GadgetReboot/PT2399_Breakout/README.md

# PT2399_Breakout
PT2399 Echo IC Breakout Board 
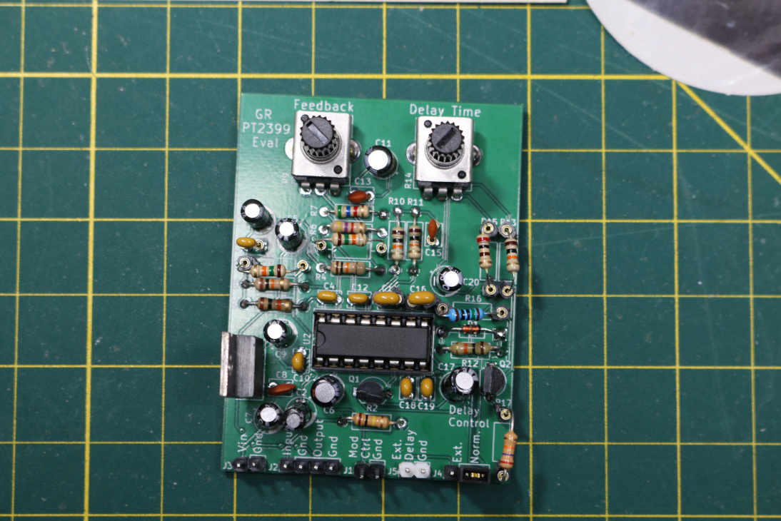
[picture p1: Assembled_PCB.JPG]
PCB
<br><br><BR><BR>
