GadgetReboot/PT2399_Breakout/GR_PT2399_Breakout_Sch.pdf

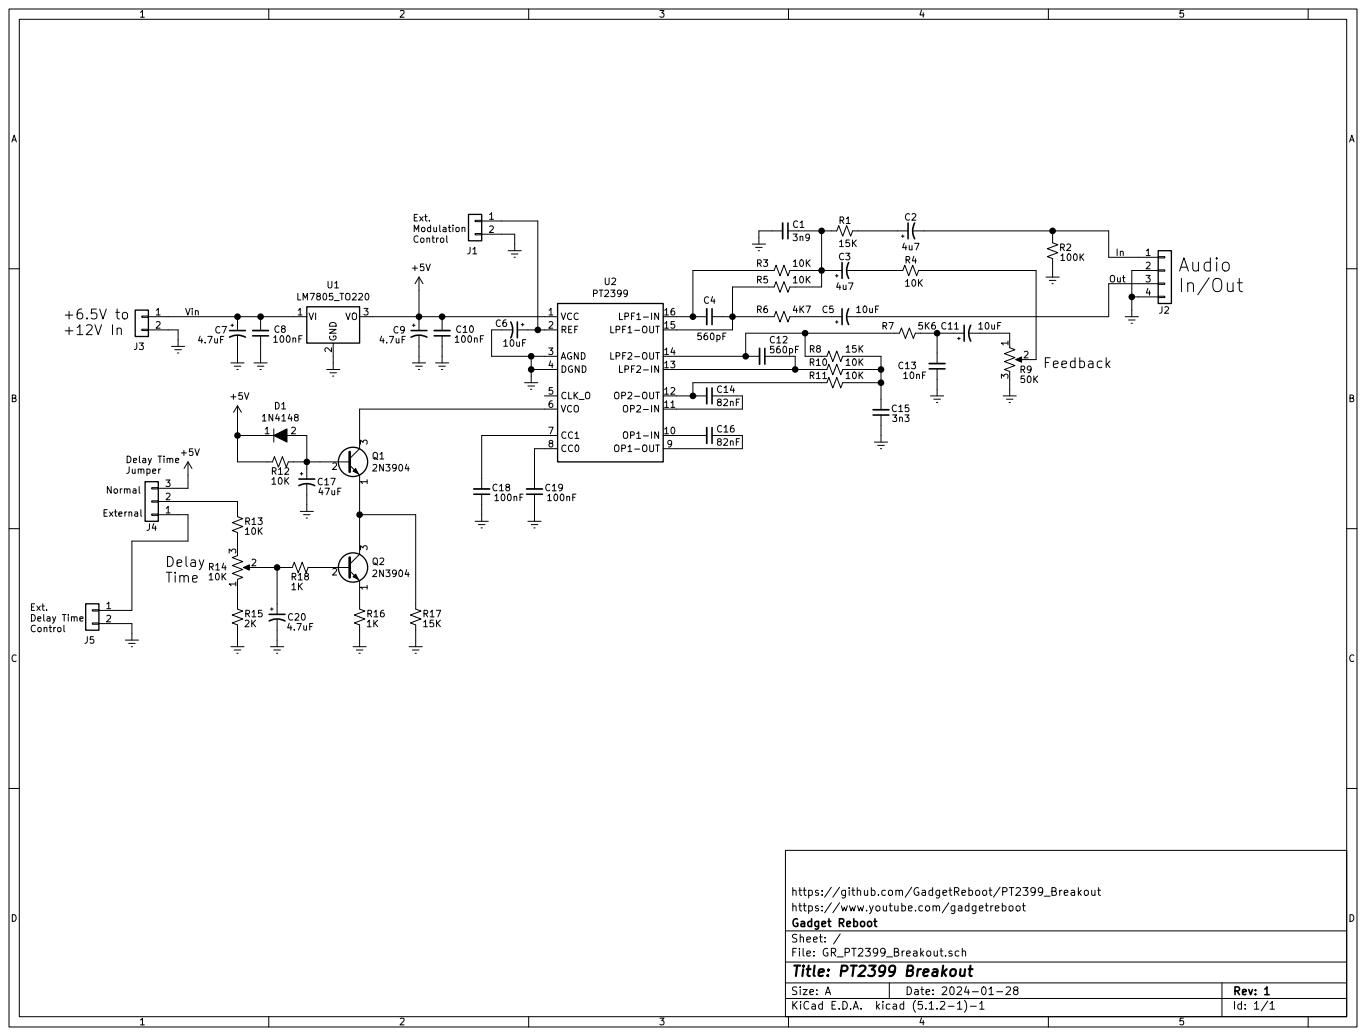
[picture p2: page 1]

Vin Ext. Delay Time Control

https://github.com/GadgetReboot/PT2399_Breakout
https://www.youtube.com/gadgetreboot
File: GR_PT2399_Breakout.sch Sheet: / Gadget Reboot
