GadgetReboot/PT2399_Breakout/KiCad/GR_PT2399_Breakout.kicad_pcb

## KiCad design KiCad/GR_PT2399_Breakout.kicad_pcb (2024-02-20)

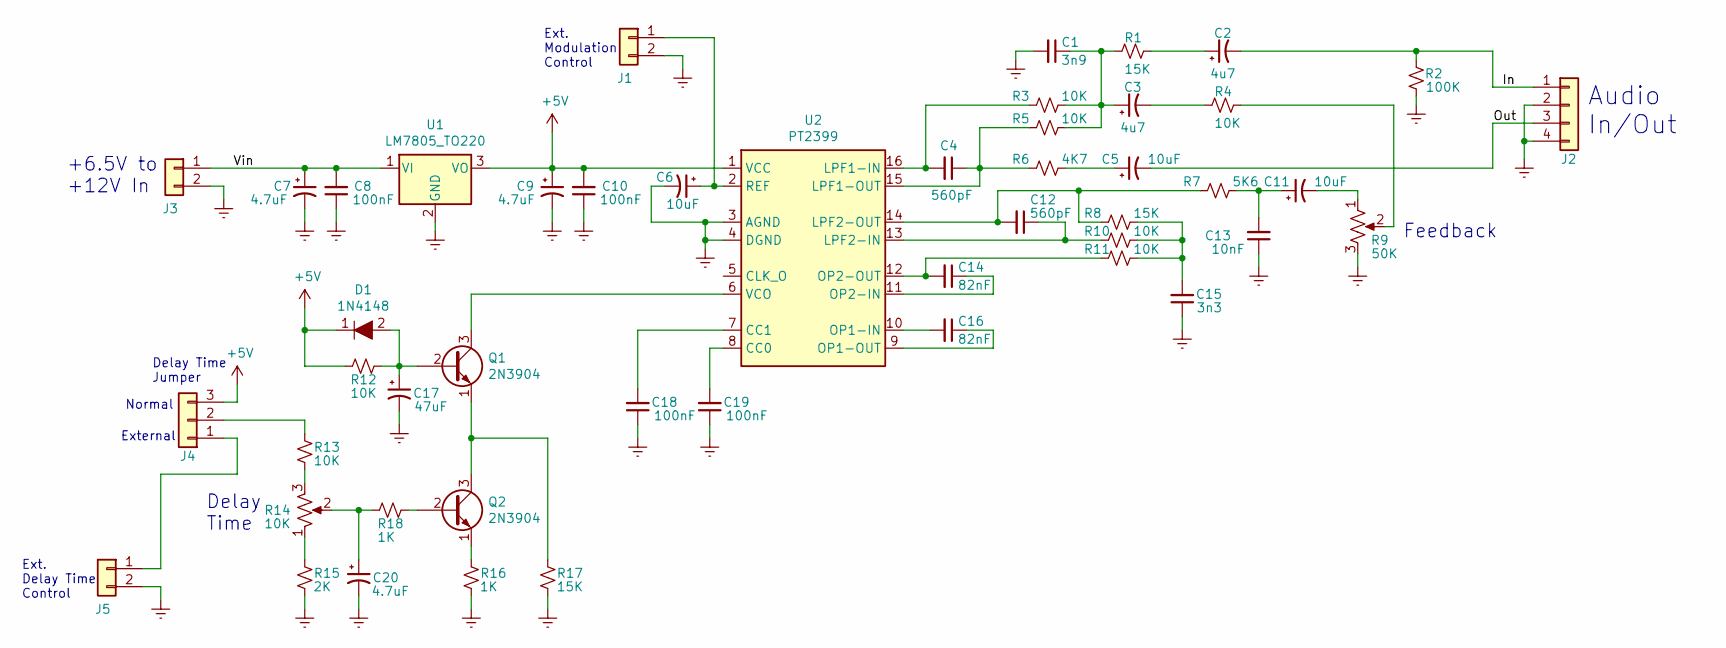
[picture p3: schematic GR_PT2399_Breakout.sch, PT2399 Breakout]

Parts:
C1: 3n9; C_Disc_D3.8mm_W2.6mm_P2.50mm
C2, C3: 4u7; CP_Radial_D5.0mm_P2.50mm
C4, C12: 560pF; C_Disc_D3.8mm_W2.6mm_P2.50mm
C5, C6, C11: 10uF; CP_Radial_D5.0mm_P2.50mm
C7, C9, C20: 4.7uF; CP_Radial_D5.0mm_P2.50mm
C8, C10, C18, C19: 100nF; C_Disc_D3.8mm_W2.6mm_P2.50mm
C13: 10nF; C_Disc_D3.8mm_W2.6mm_P2.50mm
C14, C16: 82nF; C_Disc_D3.8mm_W2.6mm_P2.50mm
C15: 3n3; C_Disc_D3.8mm_W2.6mm_P2.50mm
C17: 47uF; CP_Radial_D5.0mm_P2.50mm
D1: 1N4148; Diode_DO-35_P10mm; MPN 1N4148; Digi-Key_PN 1N4148FS-ND
J1, J3, J5: Conn_01x02; PinHeader_1x02_P2.54mm_Vertical
J2: Conn_01x04; PinHeader_1x04_P2.54mm_Vertical
J4: Conn_01x03; PinHeader_1x03_P2.54mm_Vertical
Q1, Q2: 2N3904; TO-92_Inline_Wide
R1, R8, R17: 15K; R_Axial_DIN0207_L6.3mm_D2.5mm_P10.16mm_Horizontal
R2: 100K; R_Axial_DIN0207_L6.3mm_D2.5mm_P10.16mm_Horizontal
R3, R4, R5, R10, R11, R12, R13: 10K; R_Axial_DIN0207_L6.3mm_D2.5mm_P10.16mm_Horizontal
R6: 4K7; R_Axial_DIN0207_L6.3mm_D2.5mm_P10.16mm_Horizontal
R7: 5K6; R_Axial_DIN0207_L6.3mm_D2.5mm_P10.16mm_Horizontal
R9: 50K; Potentiometer_Bourns_PTV09A-1
R14: 10K; Potentiometer_Bourns_PTV09A-1
R15: 2K; R_Axial_DIN0207_L6.3mm_D2.5mm_P10.16mm_Horizontal
R16, R18: 1K; R_Axial_DIN0207_L6.3mm_D2.5mm_P10.16mm_Horizontal
U1: LM7805_TO220; TO-220-3_Vertical
U2: PT2399; DIP-16_W7.62mm_Socket_LongPads

Connections:
+5V: C9.1, C10.2, D1.1, J4.3, R12.1, U1.3 (VO), U2.1 (VCC)
/In: C2.2, J2.1, R2.1
/Out: C5.2, J2.3
/Vin: C7.1, C8.2, J3.1, U1.1 (VI)
GNDREF: C1.2, C6.2, C7.2, C8.1, C9.2, C10.1, C13.1, C15.1, C17.2, C18.1, C19.1, C20.2, J1.2, J2.2, J2.4, J3.2, J5.2, R2.2, R9.3, R15.2, R16.2, R17.2, U1.2 (GND), U2.3 (AGND), U2.4 (DGND)
unnamed: C1.1, C3.1, R1.1, R3.2, R5.2
unnamed: C2.1, R1.2
unnamed: C3.2, R4.1
unnamed: C4.1, R5.1, R6.1, U2.15 (LPF1-OUT)
unnamed: C4.2, R3.1, U2.16 (LPF1-IN)
unnamed: C5.1, R6.2
unnamed: C6.1, J1.1, U2.2 (REF)
unnamed: C11.1, C13.2, R7.2
unnamed: C11.2, R9.1
unnamed: C12.1, R10.1, U2.13 (LPF2-IN)
unnamed: C12.2, R7.1, R8.1, U2.14 (LPF2-OUT)
unnamed: C14.1, U2.11 (OP2-IN)
unnamed: C14.2, R11.1, U2.12 (OP2-OUT)
unnamed: C15.2, R8.2, R10.2, R11.2
unnamed: C16.1, U2.9 (OP1-OUT)
unnamed: C16.2, U2.10 (OP1-IN)
unnamed: C17.1, D1.2, Q1.2 (B), R12.2
unnamed: C18.2, U2.7 (CC1)
unnamed: C19.2, U2.8 (CC0)
unnamed: C20.1, R14.2, R18.1
unnamed: J4.1, J5.1
unnamed: J4.2, R13.1
unnamed: Q1.1 (E), Q2.3 (C), R17.1
unnamed: Q1.3 (C), U2.6 (VCO)
unnamed: Q2.1 (E), R16.1
unnamed: Q2.2 (B), R18.2
unnamed: R4.2, R9.2
unnamed: R13.2, R14.3
unnamed: R14.1, R15.1

Notes on the sheet:
Audio In/Out
Delay Time Jumper
Delay Time
Normal
External
+6.5V to +12V In
Ext. Delay Time Control
Ext. Modulation Control
Feedback

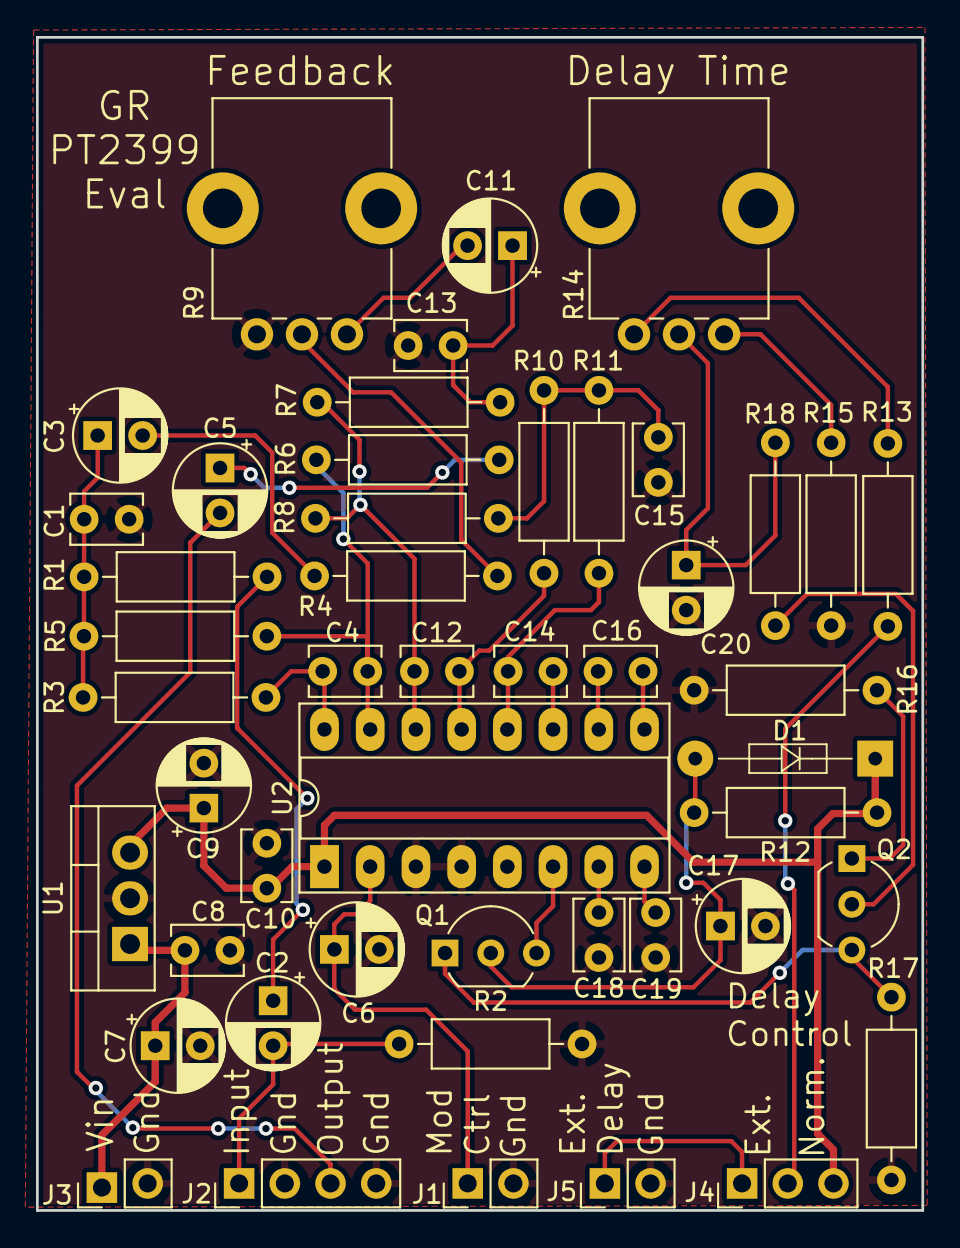
[picture p4: board GR_PT2399_Breakout.kicad_pcb from above]

Board: 2 copper layers, 49.2 x 65.2 mm, 48 parts (0 on the bottom side), 34 nets.
